RDC23/smart_fan_project/README.md

## Cool Colin - Embedded Systems Smart Fan Project ☀️

**Contributors**: Ross Cathcart, Fraser O'Regan, Ruihang Wang

---

### Overview

This project oversaw the design and construction of a desktop “smart fan” which uses tracking technology to enable the fan to autonomously follow a nearby person, making it ideal for individual use in dynamic workspaces. The tracking mechanism should increase the efficacy in cooling the person by ensuring that it is optimally positioned to promote convective heat loss from the target, reducing heat fatigue and allowing the user to feel more comfortable. 

---

### Project Build

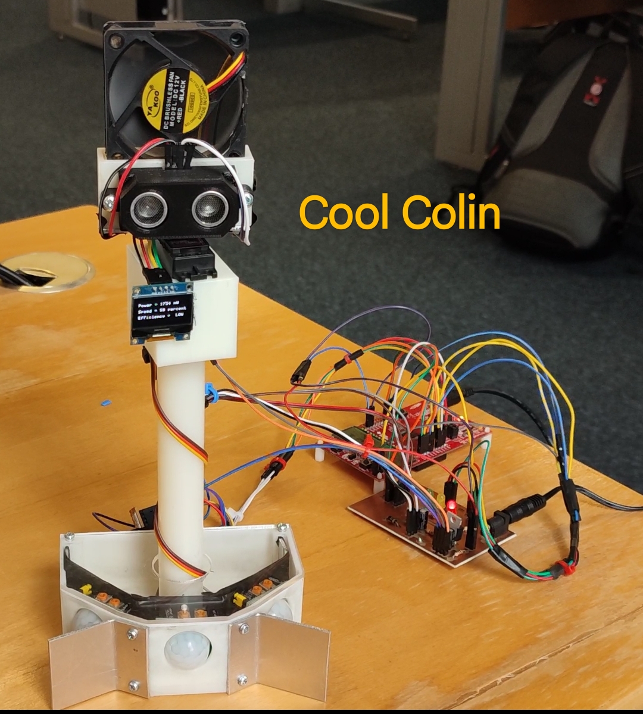
[picture p1: Images/build.jpg]


---

### Tracking Mode Demonstration 

https://github.com/RDC23/smart_fan_project/assets/112988260/db7c453c-c118-40b3-909e-dfdff9f8903a

---
