RDC23/smart_fan_project/PCB/EE318_Fan_PCB/Doc1.docx

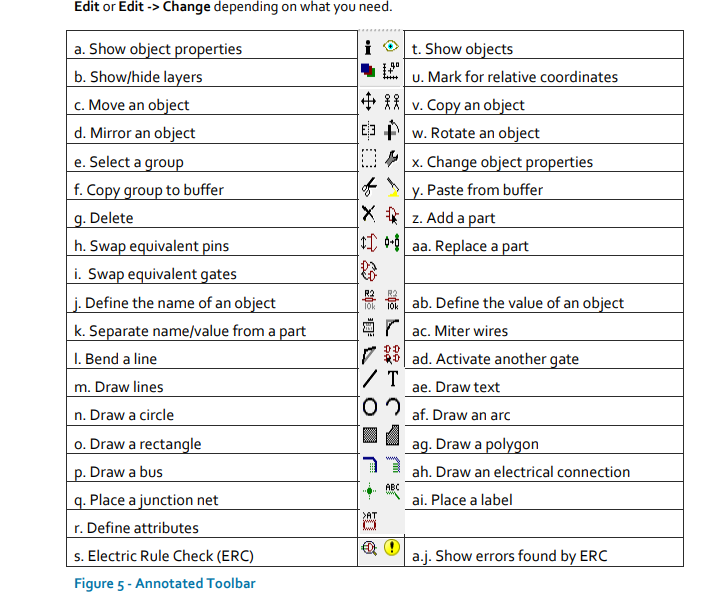
[picture p2: figure]
