RDC23/smart_fan_project/(list of files, cad)

Other CAD files:
Software Testing/oled_display/Debug/driverlib/MSP430FR2xx_4xx/sysctl.obj
Software Testing/oled_display/Debug/driverlib/MSP430FR2xx_4xx/sac.obj
Software Testing/oled_display/Debug/driverlib/MSP430FR2xx_4xx/lcd_e.obj
Software Testing/oled_display/Debug/driverlib/MSP430FR2xx_4xx/eusci_b_i2c.obj
Software Testing/oled_display/Debug/driverlib/MSP430FR2xx_4xx/rtc.obj
Software Testing/oled_display/Debug/driverlib/MSP430FR2xx_4xx/crc.obj
Software Testing/oled_display/Debug/driverlib/MSP430FR2xx_4xx/cs.obj
Software Testing/oled_display/Debug/driverlib/MSP430FR2xx_4xx/ecomp.obj
Software Testing/oled_display/Debug/driverlib/MSP430FR2xx_4xx/tia.obj
Software Testing/oled_display/Debug/driverlib/MSP430FR2xx_4xx/sfr.obj
Software Testing/oled_display/Debug/driverlib/MSP430FR2xx_4xx/pmm.obj
Software Testing/oled_display/Debug/driverlib/MSP430FR2xx_4xx/framctl.obj
Software Testing/oled_display/Debug/driverlib/MSP430FR2xx_4xx/timer_a.obj
Software Testing/oled_display/Debug/driverlib/MSP430FR2xx_4xx/mpy32.obj
Software Testing/oled_display/Debug/driverlib/MSP430FR2xx_4xx/gpio.obj
Software Testing/oled_display/Debug/driverlib/MSP430FR2xx_4xx/eusci_b_spi.obj
Software Testing/oled_display/Debug/driverlib/MSP430FR2xx_4xx/adc.obj
Software Testing/oled_display/Debug/driverlib/MSP430FR2xx_4xx/timer_b.obj
Software Testing/oled_display/Debug/driverlib/MSP430FR2xx_4xx/wdt_a.obj
Software Testing/oled_display/Debug/driverlib/MSP430FR2xx_4xx/tlv.obj
Software Testing/oled_display/Debug/driverlib/MSP430FR2xx_4xx/icc.obj
Software Testing/oled_display/Debug/driverlib/MSP430FR2xx_4xx/eusci_a_uart.obj
Software Testing/oled_display/Debug/driverlib/MSP430FR2xx_4xx/eusci_a_spi.obj
Software Testing/pir_testing/Debug/driverlib/MSP430FR2xx_4xx/adc.obj
Software Testing/pir_testing/Debug/driverlib/MSP430FR2xx_4xx/crc.obj
Software Testing/pir_testing/Debug/driverlib/MSP430FR2xx_4xx/cs.obj
Software Testing/pir_testing/Debug/driverlib/MSP430FR2xx_4xx/ecomp.obj
Software Testing/pir_testing/Debug/driverlib/MSP430FR2xx_4xx/eusci_a_spi.obj
Software Testing/pir_testing/Debug/driverlib/MSP430FR2xx_4xx/eusci_a_uart.obj
Software Testing/pir_testing/Debug/driverlib/MSP430FR2xx_4xx/eusci_b_i2c.obj
Software Testing/pir_testing/Debug/driverlib/MSP430FR2xx_4xx/eusci_b_spi.obj
Software Testing/pir_testing/Debug/driverlib/MSP430FR2xx_4xx/framctl.obj
Software Testing/pir_testing/Debug/driverlib/MSP430FR2xx_4xx/gpio.obj
Software Testing/pir_testing/Debug/driverlib/MSP430FR2xx_4xx/icc.obj
Software Testing/pir_testing/Debug/driverlib/MSP430FR2xx_4xx/lcd_e.obj
Software Testing/pir_testing/Debug/driverlib/MSP430FR2xx_4xx/mpy32.obj
Software Testing/pir_testing/Debug/driverlib/MSP430FR2xx_4xx/pmm.obj
Software Testing/pir_testing/Debug/driverlib/MSP430FR2xx_4xx/rtc.obj
Software Testing/pir_testing/Debug/driverlib/MSP430FR2xx_4xx/sac.obj
Software Testing/pir_testing/Debug/driverlib/MSP430FR2xx_4xx/sfr.obj
Software Testing/pir_testing/Debug/driverlib/MSP430FR2xx_4xx/sysctl.obj
Software Testing/pir_testing/Debug/driverlib/MSP430FR2xx_4xx/tia.obj
Software Testing/pir_testing/Debug/driverlib/MSP430FR2xx_4xx/timer_a.obj
Software Testing/pir_testing/Debug/driverlib/MSP430FR2xx_4xx/timer_b.obj
Software Testing/pir_testing/Debug/driverlib/MSP430FR2xx_4xx/tlv.obj
Software Testing/pir_testing/Debug/driverlib/MSP430FR2xx_4xx/wdt_a.obj
