RDC23/smart_fan_project/PCB/EE318_Fan_PCB/318_PCB_FOR.brd

## EAGLE design PCB/EE318_Fan_PCB/318_PCB_FOR.brd (2024-03-21)

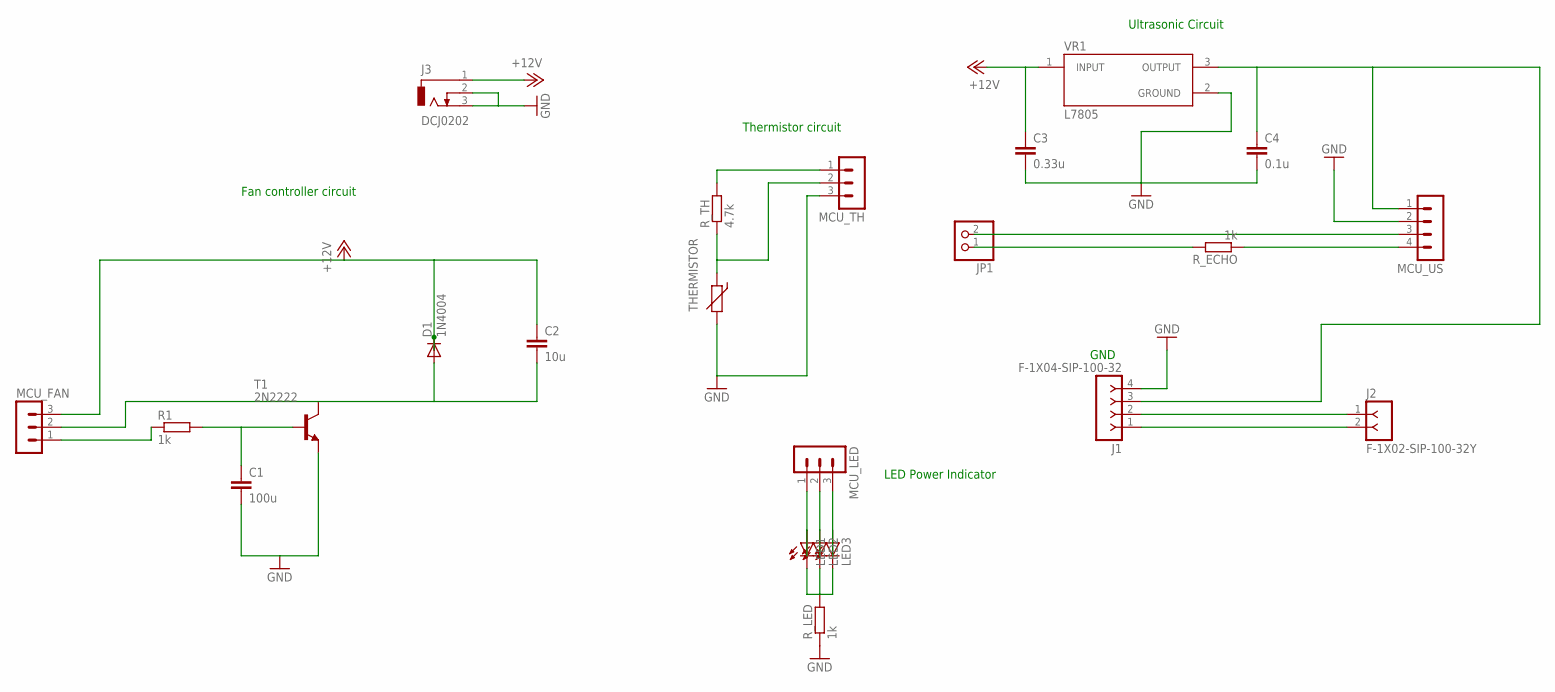
[picture p3: schematic 318_PCB_FOR.sch]

Parts:
C1: 100u; C025-025X050
C2: 10u; C025-025X050
C3: 0.33u; C025-025X050
C4: 0.1u; C025-025X050
D1: 1N4004; DO41-10
J1: F-1X04-SIP-100-32; SIP-100-04-32
J2: F-1X02-SIP-100-32Y; SIP-100-02-32Y
J3: DCJ0202
JP1: PINHD-1X2; 1X02
LED1, LED2, LED3: LEDSFH480; SFH480
MCU_FAN: MA03-1
MCU_LED: MA03-1
MCU_TH: MA03-1
MCU_US: MA04-1
R1: 1k; 0207/10
R_ECHO: 1k; 0207/10
R_LED: 1k; 0207/10
R_TH: 4.7k; 0207/10
T1: 2N2222; TO18
THERMISTOR: THERMISTOR-5; R-5
VR1: L7805; TO255P1020X450X2000-3

Connections:
3V3: MCU_TH.1, R_TH.2
+12V: C2.1, C3.1, D1.C, J3.1, MCU_FAN.3, VR1.1 (INPUT)
AMBER: LED2.A, MCU_LED.2
FAN_BLACK: C2.2, D1.A, MCU_FAN.2, T1.3 (C)
GND: C1.2, C3.2, C4.2, J1.4, J3.2, J3.3, MCU_TH.3, MCU_US.2, R_LED.1, T1.1 (E), THERMISTOR.2, VR1.2 (GROUND)
GREEN: LED1.A, MCU_LED.1
unnamed: C1.1, R1.2, T1.2 (B)
unnamed: MCU_US.4, R_ECHO.1
unnamed: LED1.K (C), LED2.K (C), LED3.K (C), R_LED.2
unnamed: JP1.2, MCU_US.3
unnamed: C4.1, J1.3, MCU_US.1, VR1.3 (OUTPUT)
unnamed: JP1.1, R_ECHO.2
unnamed: J1.1, J2.2
unnamed: J1.2, J2.1
P1.6: MCU_FAN.1, R1.1
P8.1: MCU_TH.2, R_TH.1, THERMISTOR.1
RED: LED3.A, MCU_LED.3

Notes on the sheet:
Ultrasonic Circuit
Fan controller circuit
Thermistor circuit
LED Power Indicator
GND

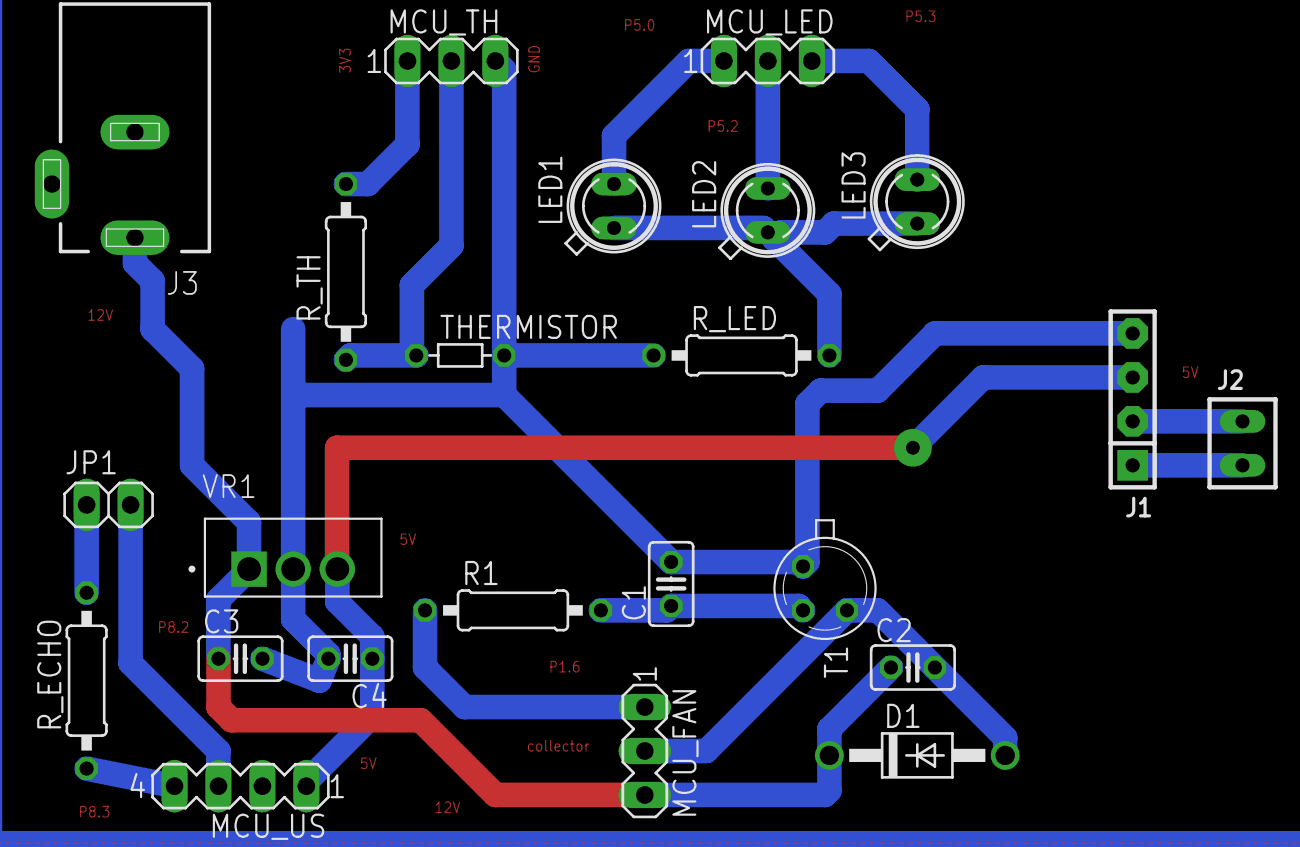
[picture p4: board 318_PCB_FOR.brd from above]

Board: 2 copper layers, 23 parts (0 on the bottom side), 17 nets.
