RDC23/smart_fan_project/Software Testing/oled_screen_wang/DriverLib Examples/SCREEN/gpio/gpio_ex4_writeToPort1.c

//******************************************************************************
//!   Write a byte to Port 1
//!
//!   Description: Writes a byte (0xFF) to Port 1 and stays in LPM4 mode.
//!   ACLK = n/a, MCLK = SMCLK = default DCO
//!
//!                MSP430FR4133
//!             -----------------
//!         /|\|                 |
//!          | |                 |
//!          --|RST              |
//!            |             P1.x|-->HI
//!            |                 |
//!            |                 |
//!
//! This example uses the following peripherals and I/O signals.  You must
//! review these and change as needed for your own board:
//! - GPIO Port peripheral
//!
//! This example uses the following interrupt handlers.  To use this example
//! in your own application, you must add these interrupt handlers to your
//! vector table.
//! - None.
//!
//******************************************************************************

#include "driverlib.h"
#include "oled.h"
#include "stdio.h"

char tab[48];
uint32_t distance1 = 0;
uint32_t distance2 = 0;
uint32_t distance3 = 0;

void main(void)
{
    // Stop watchdog timer
    WDT_A_hold(WDT_A_BASE);

    // Test 1 start

    GPIO_setAsOutputPin(GPIO_PORT_P1, GPIO_PIN5 + GPIO_PIN4); // Set as output mode
    GPIO_setOutputLowOnPin(GPIO_PORT_P1, GPIO_PIN5);          // SDA P1.5
    GPIO_setOutputLowOnPin(GPIO_PORT_P1, GPIO_PIN4);          // SCK P1.4

    ssd1306_init();             // Initialize SSD1306 OLED
    ssd1306_clearDisplay();     // Clear OLED display

    char txtBlock[93] = "This is a very large some may say huge message to test the functionality of the screen";
    
    
    ssd1306_printTextBlock(0, 1, txtBlock);
    __delay_cycles(10000000);
    ssd1306_clearDisplay();

    // Print Single Lines of Text at each row

    ssd1306_printText(0, 1, "ROSS");
    ssd1306_printText(0, 2, "RUIHANG");
    ssd1306_printText(0, 3, "FRASER");
    ssd1306_printText(0, 4, "UWAIS");
    // ssd1306_printText(0, 5, "Line 5");
    // ssd1306_printText(0, 6, "Line 6");
    // ssd1306_printText(0, 7, "Line 7");
    // ssd1306_clearDisplay();

    // Print these at a column other than zero
    // ssd1306_printText(40, 1, "40");
    // ssd1306_printText(50, 2, "50");
    // ssd1306_printText(60, 3, "60");
    // ssd1306_printText(70, 4, "70");
    // ssd1306_printText(80, 5, "80");
    // ssd1306_printText(90, 6, "90");
    // ssd1306_printText(100, 7, "100");

    // Test 1 stop

    while (1)
        ; // Infinite loop
}
