RDC23/smart_fan_project/demo_code/oledfont.h

// oledfont.h
// Author: Ruihang Wang
// Module: Smart Fan Project
// Last update: 07/03/2024
// Description: Implementation file for OLED display functions.

#ifndef OLED_FONT_H_
#define OLED_FONT_H_

// Hex mapping table for characters to dispay on screen, adapted from STM32 library
const unsigned char font_5x7n[96][5] = {{0x00, 0x00, 0x00, 0x00, 0x00},  // space
                                       {0x00, 0x00, 0x4F, 0x00, 0x00},  // !
                                       {0x00, 0x07, 0x00, 0x07, 0x00},  // "
                                       {0x14, 0x7F, 0x14, 0x7F, 0x14},  // #
                                       {0x24, 0x2A, 0x7F, 0x2A, 0x12},  // $
                                       {0x23, 0x13, 0x08, 0x64, 0x62},  // %
                                       {0x36, 0x49, 0x55, 0x22, 0x50},  // &
                                       {0x00, 0x05, 0x03, 0x00, 0x00},  // '
                                       {0x00, 0x1C, 0x22, 0x41, 0x00},  // (
                                       {0x00, 0x41, 0x22, 0x1C, 0x00},  // )
                                       {0x14, 0x08, 0x3E, 0x08, 0x14},  // *
                                       {0x08, 0x08, 0x3E, 0x08, 0x08},  // +
                                       {0x00, 0x50, 0x30, 0x00, 0x00},  // ,
                                       {0x08, 0x08, 0x08, 0x08, 0x08},  // -
                                       {0x00, 0x60, 0x60, 0x00, 0x00},  // .
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
                                       {0x44, 0x28, 0x10, 0x28, 0x44},  // x
                                       {0x0C, 0x50, 0x50, 0x50, 0x3C},  // y
                                       {0x44, 0x64, 0x54, 0x4C, 0x44},  // z
};

#endif /* OLED_FONT_H_ */
