RDC23/smart_fan_project/(commit log)

2024-01-03 file structure created
    [adc.obj, crc.obj, cs.obj, ecomp.obj, eusci_a_spi.obj, eusci_a_uart.obj, eusci_b_i2c.obj, eusci_b_spi.obj]
2024-01-03 fixed file system
    [adc.obj, crc.obj, cs.obj, ecomp.obj, eusci_a_spi.obj, eusci_a_uart.obj, eusci_b_i2c.obj, eusci_b_spi.obj]
2024-01-09 added servo and ultrasonic libraries
2024-01-21 temp sensor working, mode toggle button and display working
2024-01-21 decoupled isr button for mode toggle into seperate func
2024-01-28 Added external button support and servo integration
2024-01-29 started writing driver for fan pwm
2024-02-02 update servo increment speed
2024-02-03 fixed the upper lower PWM bounds for using mg946r servo
    [servo.h]
2024-02-04 Update fancontroller.c
    fixed timer ta1ccr2 write from ta0ccr2 since we are using Timer A instance 1
    [fancontroller.c]
2024-02-04 added servo/fan pwm test code and created a dedicated testing folder
2024-02-04 added test code
    [adc.obj, crc.obj, cs.obj, ecomp.obj, eusci_a_spi.obj, eusci_a_uart.obj, eusci_b_i2c.obj, eusci_b_spi.obj]
2024-02-05 updated fancontroller driver to attempt to use timer a0 and add in min/ max duty cycles. Needs tested with servo in lab. If it works, write ultility functions to control fan speed at a higher level o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
2024-02-08 fixed servo pwm max value, added startup torque motor func, started decoder driver
    [decoder.c, decoder.h]
2024-02-10 fan thermo to speed finished. Fan api added extra functions
2024-02-11 added power led support for thermo/fan test code. Fixed ultrasonic pin assignment
    [main.c, ultrasonic.c, ultrasonic.h]
2024-02-13 servo code updated so that api keeps track of current angle, not main code. Drafted PIR code. Need to add ultrasonics support
2024-02-15 Update ultrasonic.c
    fix register port to port 8
    [ultrasonic.c]
2024-02-15 Update fancontroller.c
    fixed fan pwm timer setup in fan_init() - it wasn't setting the TA0CTL or TACCR0 before so PWM wasnt working
    [fancontroller.c]
2024-02-17 working 2 pir and ultrasonic targeting.
2024-02-20 updated fan library to add power calculation function, and hal_LCD to print the power to screen. Both need tested.
2024-02-20 fan.h added
2024-02-22 screen code upload issue
    [main.c]
2024-02-23 Update thermistor.c
    update thermistor value
2024-02-23 demo (master) code development and bug fixing
    [fancontroller.c, fancontroller.h, hal_LCD.c, hal_LCD.h, main.c, pir.c, pir.h, servo.c]
2024-02-23 updated screen driver interrupt vector
2024-02-24 button input register and power print fixed. Debounce on on/off button not great
    [fancontroller.c, hal_LCD.c, main.c, pir.h]
2024-02-25 Update servo.h
    servo delay increased to slow movement
2024-02-27 screen update. not working
    [main.c]
2024-02-28 fixed i2c interrupt enable. Was using UART one instead! Need to use UCTXIFGn NOT UCTIFG!
2024-03-01 fixed power calculation function for better precision
    [fancontroller.c, hal_LCD.c, main.c]
2024-03-01 Update i2c.c
    ifg flag changed after Bruce comment
2024-03-07 added screen support to main. Issues with screen buffer overflow need fixed
    [fancontroller.c, fancontroller.h, main.c, oled.c, oled.h]
2024-03-12 fixed screen dots issue and printing issues. Added refresh rate support to main to avoid blocking aspect of display. Only update screen after n cycles of main
    [adc.obj, crc.obj, cs.obj, ecomp.obj, eusci_a_spi.obj, eusci_a_uart.obj, eusci_b_i2c.obj, eusci_b_spi.obj]
2024-03-21 Add files via upload
    added board and schematic files to print
    [318_PCB_FOR.brd, 318_PCB_FOR.sch]
2024-03-29 Update fancontroller.h
    update temp threshold for stability
    [fancontroller.h]
2024-03-29 updated servo angle (20 to 160 limits), added sdg print and fixed oled issue - oled needs connected at startup of msp to function. Otherwise initialisation commands aren't sent
    [main.c, oled.c, servo.h]
2024-04-18 ultrasonic and pir working
2024-05-05 Update README.md
    added video of track mode
